Collin-Brock/Combat-Robotics/assets/DopamineNewBody.png

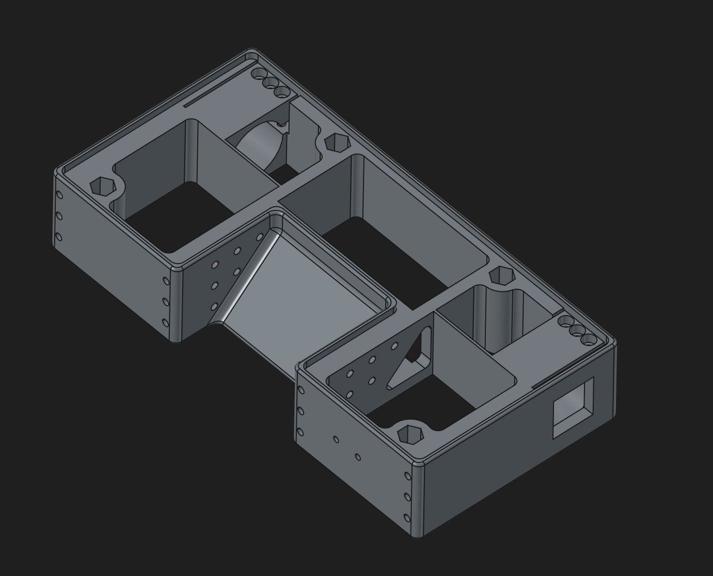
assets/DopamineNewBody.png
