Collin-Brock/Combat-Robotics/assets/nullV1BeforeWire.jpg

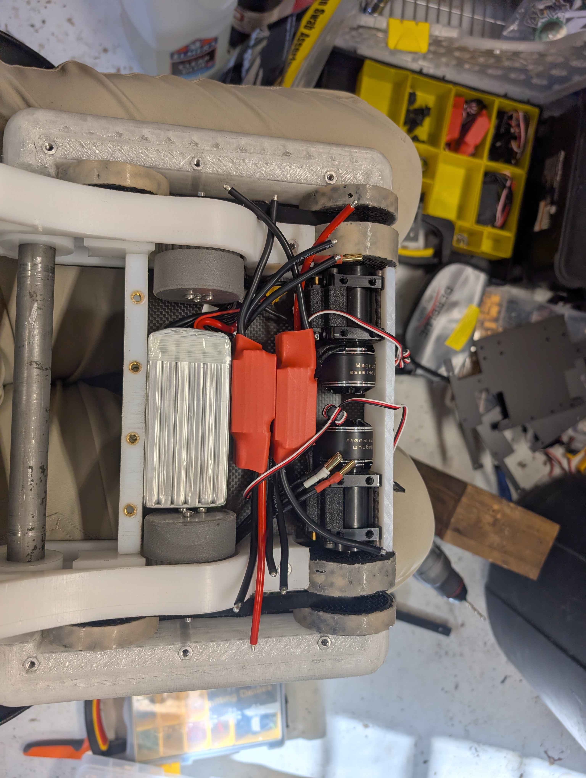
assets/nullV1BeforeWire.jpg
