Collin-Brock/Combat-Robotics/Dopamine CAD/Dopamine Weapon.FCStd

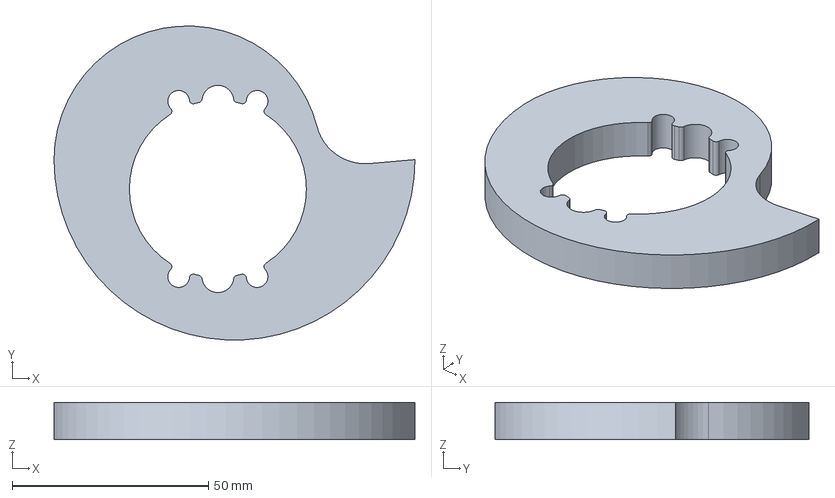
[picture p17: CAD file, 2025-05-22]
Dopamine CAD/Dopamine Weapon.FCStd
92.1 x 80.0 x 9.53 mm
