Collin-Brock/Combat-Robotics/Dopamine CAD/Dopamine Bodyv2 TOP PLATE.step

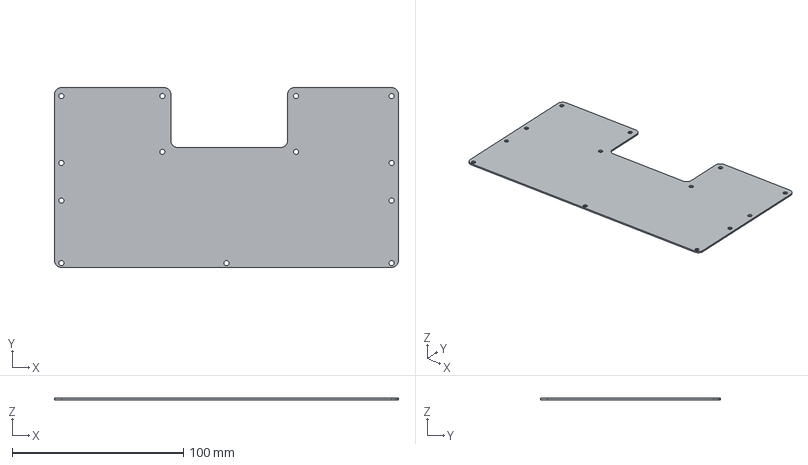
[picture p18: CAD file, 2025-05-22]
Dopamine CAD/Dopamine Bodyv2 TOP PLATE.step
200.8 x 105.0 x 1.00 mm
