Collin-Brock/Combat-Robotics/Dopamine CAD/Dopamine Weapon Support-v3.step

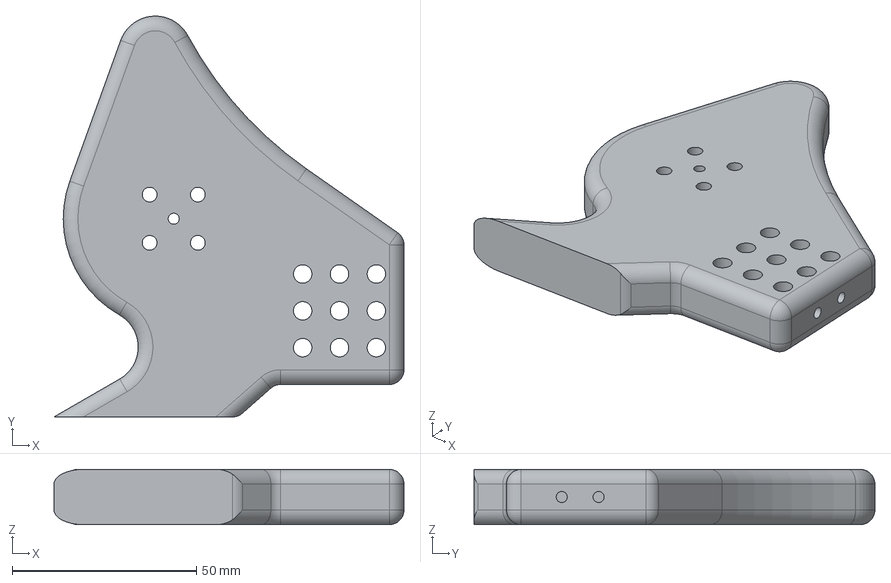
[picture p19: CAD file, 2025-05-22]
Dopamine CAD/Dopamine Weapon Support-v3.step
95.0 x 108.8 x 15.0 mm
