Collin-Brock/Combat-Robotics/Dopamine CAD/Repeat Max.FCStd

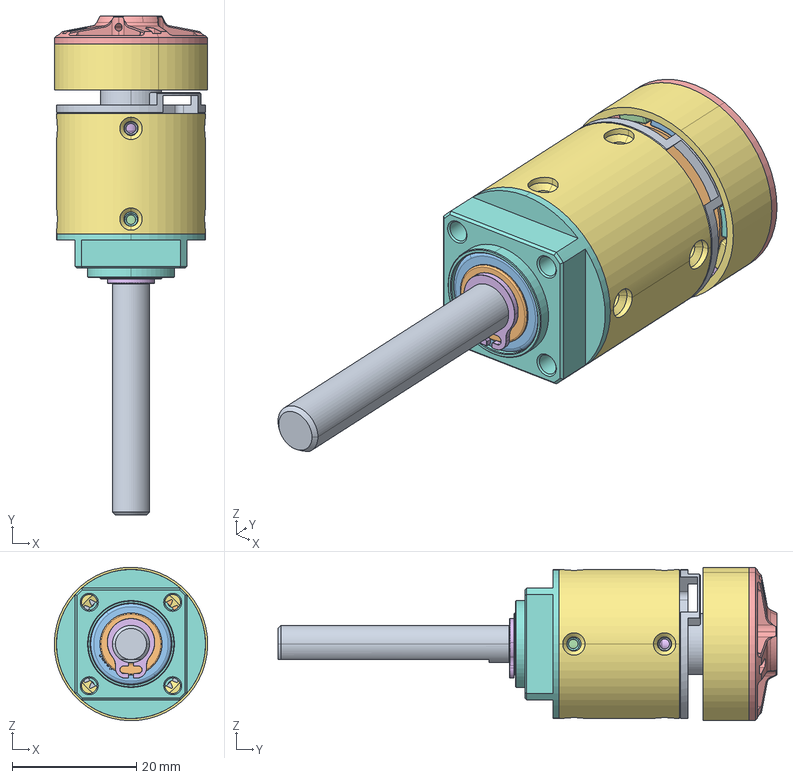
[picture p20: CAD file, 2025-05-22]
Dopamine CAD/Repeat Max.FCStd
24.7 x 80.3 x 24.7 mm
____^_________PGM24+TM2006Modified.STEP
____-0^_________PGM24+TM2006Modified.STEP
3x7x3____^_________PGM24+TM2006Modified.STEP
3x7x3____^_________PGM24+TM2006Modified.STEP001
____-1^________-1_PGM24+TM2006Modified.STEP
__^________-1_PGM24+TM2006Modified.STEP
____-2^________-1_PGM24+TM2006Modified.STEP
____-3^________-1_PGM24+TM2006Modified.STEP
____-3^________-1_PGM24+TM2006Modified.STEP001
____-3^________-1_PGM24+TM2006Modified.STEP002
____-3^________-1_PGM24+TM2006Modified.STEP003
____-3^________-1_PGM24+TM2006Modified.STEP004
____-3^________-1_PGM24+TM2006Modified.STEP005
____-3^________-1_PGM24+TM2006Modified.STEP006
____-3^________-1_PGM24+TM2006Modified.STEP007
____-3^________-1_PGM24+TM2006Modified.STEP008
____-3^________-1_PGM24+TM2006Modified.STEP009
____-3^________-1_PGM24+TM2006Modified.STEP010
____-3^________-1_PGM24+TM2006Modified.STEP011
____-3^________-1_PGM24+TM2006Modified.STEP012
____-3^________-1_PGM24+TM2006Modified.STEP013
C____6^Max V2 GB(2)_Max V2 GB
GMP24______19.4_M0.4X46^Max V2 GB(2)_Max V2 GB
GMP24______^Max V2 GB(2)_Max V2 GB
______^Max V2 GB(2)_Max V2 GB
__________^Max V2 GB(2)_Max V2 GB
____686RS^Max V2 GB(2)_Max V2 GB
____686RS^Max V2 GB(2)_Max V2 GB001
