Collin-Brock/Combat-Robotics/Dopamine CAD/Dopamine Bodyv2.step

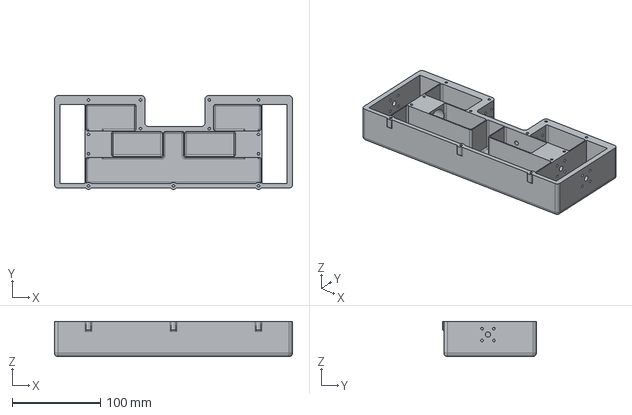
[picture p21: CAD file, 2025-05-22]
Dopamine CAD/Dopamine Bodyv2.step
270.0 x 106.5 x 40.0 mm
