Collin-Brock/Combat-Robotics/Dopamine CAD/3in wheels.step

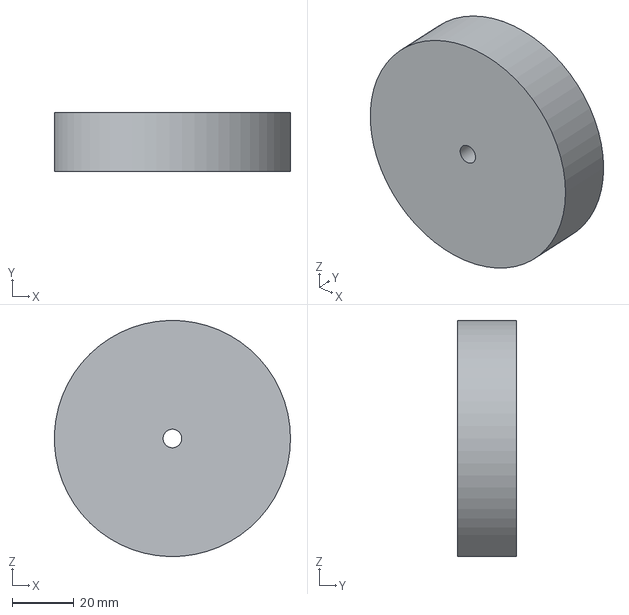
[picture p22: CAD file, 2025-05-22]
Dopamine CAD/3in wheels.step
76.1 x 19.1 x 76.2 mm
