Collin-Brock/Combat-Robotics/Dopamine CAD/Repeat 2812.FCStd

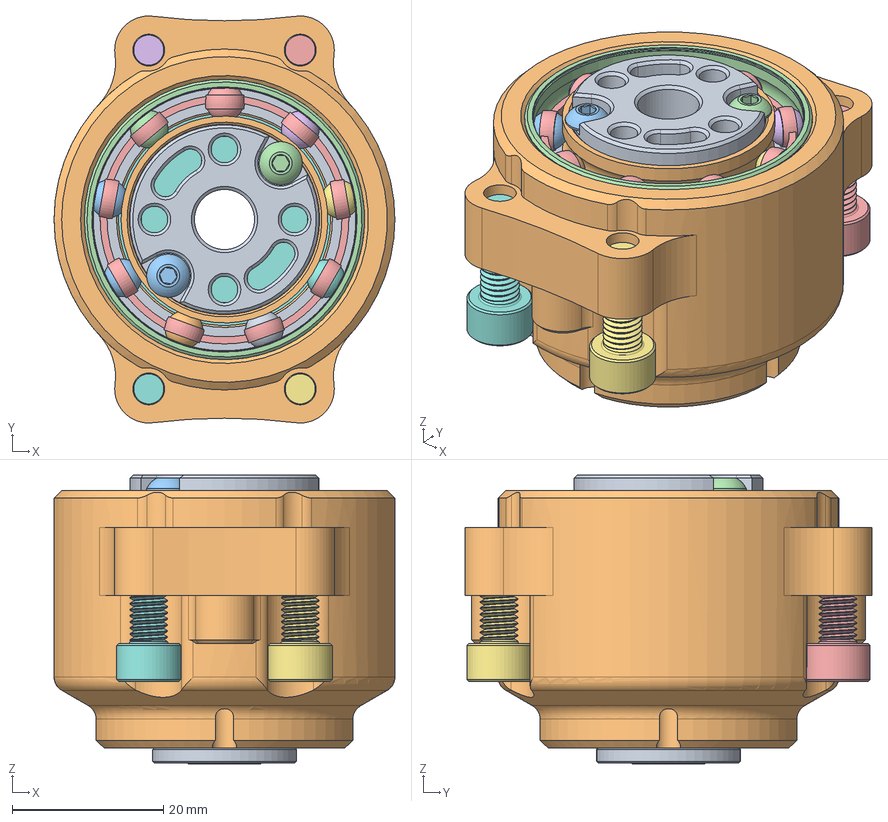
[picture p23: CAD file, 2025-05-22]
Dopamine CAD/Repeat 2812.FCStd
45.0 x 53.7 x 38.1 mm
M2812-1_Flat^M2812-MagRing_HUB-2812-V1.0(2)_HUB-2812-V1.0
M2812-2^M2812-MagRing_HUB-2812-V1.0(2)_HUB-2812-V1.0
M2812-4^M2812-MagRing_HUB-2812-V1.0(2)_HUB-2812-V1.0
M2812-4^M2812-MagRing_HUB-2812-V1.0(2)_HUB-2812-V1.001
M2812-4^M2812-MagRing_HUB-2812-V1.0(2)_HUB-2812-V1.002
M2812-4^M2812-MagRing_HUB-2812-V1.0(2)_HUB-2812-V1.003
M2812-4^M2812-MagRing_HUB-2812-V1.0(2)_HUB-2812-V1.004
M2812-4^M2812-MagRing_HUB-2812-V1.0(2)_HUB-2812-V1.005
M2812-4^M2812-MagRing_HUB-2812-V1.0(2)_HUB-2812-V1.006
M2812-4^M2812-MagRing_HUB-2812-V1.0(2)_HUB-2812-V1.007
M2812-4^M2812-MagRing_HUB-2812-V1.0(2)_HUB-2812-V1.008
M2812-4^M2812-MagRing_HUB-2812-V1.0(2)_HUB-2812-V1.009
M2812-4^M2812-MagRing_HUB-2812-V1.0(2)_HUB-2812-V1.010
M2812-4^M2812-MagRing_HUB-2812-V1.0(2)_HUB-2812-V1.011
M2812-4^M2812-MagRing_HUB-2812-V1.0(2)_HUB-2812-V1.012
M2812-4^M2812-MagRing_HUB-2812-V1.0(2)_HUB-2812-V1.013
M2812-1_Flat^M2812-MagRing_HUB-2812-V1.0(2)_HUB-2812-V1.001
6805_5972K216^HUB-2812-V1.0(2)_HUB-2812-V1.0
6805_5972K216^HUB-2812-V1.0(2)_HUB-2812-V1.001
6805_5972K216^HUB-2812-V1.0(2)_HUB-2812-V1.002
6805_5972K216^HUB-2812-V1.0(2)_HUB-2812-V1.003
6805_5972K216^HUB-2812-V1.0(2)_HUB-2812-V1.004
6805_5972K216^HUB-2812-V1.0(2)_HUB-2812-V1.005
6805_5972K216^HUB-2812-V1.0(2)_HUB-2812-V1.006
6805_5972K216^HUB-2812-V1.0(2)_HUB-2812-V1.007
6805_5972K216^HUB-2812-V1.0(2)_HUB-2812-V1.008
6805_5972K216^HUB-2812-V1.0(2)_HUB-2812-V1.009
6805_5972K216^HUB-2812-V1.0(2)_HUB-2812-V1.010
6805_5972K216^HUB-2812-V1.0(2)_HUB-2812-V1.011
6000_5972K241^HUB-2812-V1.0(2)_HUB-2812-V1.0
6000_5972K241^HUB-2812-V1.0(2)_HUB-2812-V1.001
6000_5972K241^HUB-2812-V1.0(2)_HUB-2812-V1.002
6000_5972K241^HUB-2812-V1.0(2)_HUB-2812-V1.003
6000_5972K241^HUB-2812-V1.0(2)_HUB-2812-V1.004
6000_5972K241^HUB-2812-V1.0(2)_HUB-2812-V1.005
6000_5972K241^HUB-2812-V1.0(2)_HUB-2812-V1.006
6000_5972K241^HUB-2812-V1.0(2)_HUB-2812-V1.007
6000_5972K241^HUB-2812-V1.0(2)_HUB-2812-V1.008
6000_5972K241^HUB-2812-V1.0(2)_HUB-2812-V1.009
M2812-6^HUB-2812-V1.0(2)_HUB-2812-V1.0
2812-HUB-001^HUB-2812-V1.0(2)_HUB-2812-V1.0
2812-HUB-002^HUB-2812-V1.0(2)_HUB-2812-V1.0
M3x4_91239A109^HUB-2812-V1.0(2)_HUB-2812-V1.0
M3x4_91239A109^HUB-2812-V1.0(2)_HUB-2812-V1.001
M5x14_91290A230^HUB-2812-V1.0(2)_HUB-2812-V1.0
M5x14_91290A230^HUB-2812-V1.0(2)_HUB-2812-V1.001
M5x14_91290A230^HUB-2812-V1.0(2)_HUB-2812-V1.002
M5x14_91290A230^HUB-2812-V1.0(2)_HUB-2812-V1.003
2812-HUB-005^HUB-2812-V1.0(2)_HUB-2812-V1.0
