Collin-Brock/Combat-Robotics/(list of files, cad)

Other CAD files:
Dopamine CAD/Dopamine Weapon Support.FCStd
Dopamine CAD/Dopamine.FCStd
Dopamine CAD/Dopamine Weapon Support-v3 LHS.step
Dopamine CAD/3in wheels.FCStd
Dopamine CAD/Dopamine Bodyv2 TOP PLATE.FCStd
Dopamine CAD/Dopamine Bodyv2.FCStd
