Collin-Brock/Combat-Robotics/(commit log)

2025-05-22 Create Dopamine CAD
2025-05-22 Create Print Settings.txt
2025-05-22 Update Print Settings.txt
